FrodoVDR/PylontechMonitoring_ESP32-S3/hardware/PylontechInterface.kicad_sch

## KiCad design hardware/PylontechInterface.kicad_sch (2026-07-24)

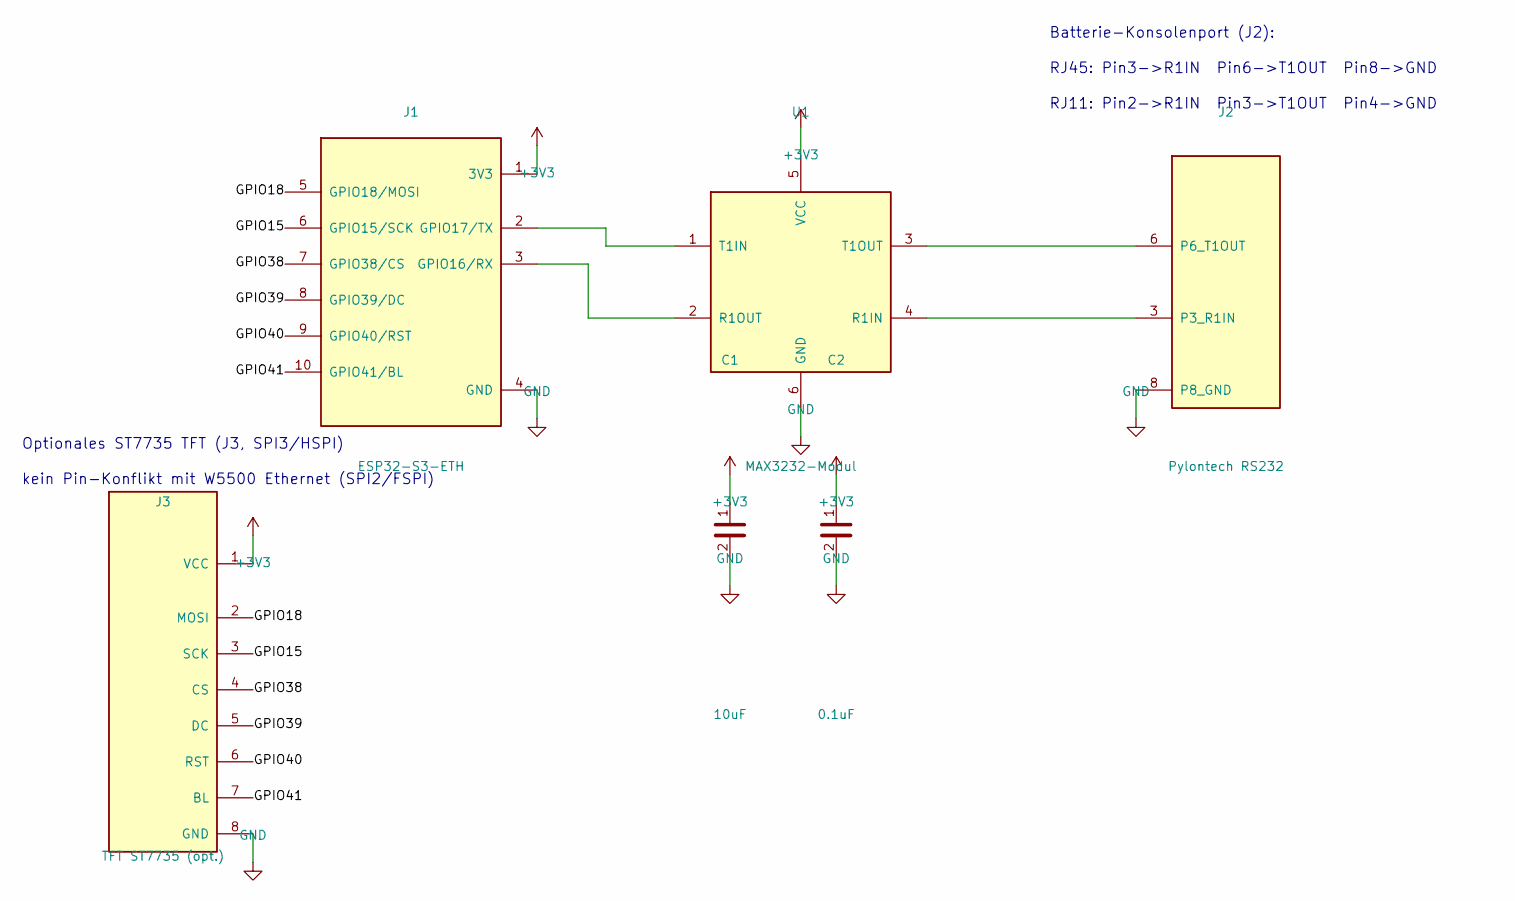
[picture p2: schematic PylontechInterface.kicad_sch]

Parts:
C1: 10uF
C2: 0.1uF
J1: ESP32-S3-ETH
J2: Pylontech RS232
J3: TFT ST7735 (opt.)
U1: MAX3232-Modul

Connections:
+3V3: C1.1, C2.1, J1.1 (3V3), J3.1 (VCC), U1.5 (VCC)
GND: C1.2, C2.2, J1.4 (GND), J2.8 (P8_GND), J3.8 (GND), U1.6 (GND)
GPIO15: J1.6 (GPIO15/SCK), J3.3 (SCK)
GPIO18: J1.5 (GPIO18/MOSI), J3.2 (MOSI)
GPIO38: J1.7 (GPIO38/CS), J3.4 (CS)
GPIO39: J1.8 (GPIO39/DC), J3.5 (DC)
GPIO40: J1.9 (GPIO40/RST), J3.6 (RST)
GPIO41: J1.10 (GPIO41/BL), J3.7 (BL)
unnamed: J1.2 (GPIO17/TX), U1.1 (T1IN)
unnamed: J1.3 (GPIO16/RX), U1.2 (R1OUT)
unnamed: J2.3 (P3_R1IN), U1.4 (R1IN)
unnamed: J2.6 (P6_T1OUT), U1.3 (T1OUT)

Notes on the sheet:
Batterie-Konsolenport (J2):
RJ45: Pin3->R1IN Pin6->T1OUT Pin8->GND
RJ11: Pin2->R1IN Pin3->T1OUT Pin4->GND
Optionales ST7735 TFT (J3, SPI3/HSPI)
kein Pin-Konflikt mit W5500 Ethernet (SPI2/FSPI)
