FrodoVDR/PylontechMonitoring_ESP32-S3/config.h

#pragma once
#include <Arduino.h>
#include <Preferences.h>
#include <map>
#include <vector>
#include <utility>
#include <freertos/FreeRTOS.h>
#include <freertos/semphr.h>

// Mutexes für thread-sicheren Zugriff auf lastParsedStat / lastParsedInfo / lastParsedBat / PWR-Buffer
extern SemaphoreHandle_t g_statMutex;
extern SemaphoreHandle_t g_infoMutex;
extern SemaphoreHandle_t g_batMutex;

// Boot-time reset/crash snapshot (defined in PylontechMonitoring.ino),
// exposed via /api/monitoring so the last crash stage survives log rotation.
extern String g_resetReasonStr;
extern uint32_t g_bootCrashStage;
extern const char* g_bootCrashStageName;
extern uint32_t g_bootCrashCount;
extern uint32_t g_bootCrashStageNRT;
extern const char* g_bootCrashStageNRTName;
extern SemaphoreHandle_t g_pwrMutex;
extern SemaphoreHandle_t g_healthMutex;

// ---------------------------------------------------------
// Timezone entry structure (Region → City → IANA → POSIX)
// ---------------------------------------------------------
struct TimezoneEntry {
    const char* region;
    const char* city;
    const char* tzName;
    const char* posix;
};


String getTimezoneJson();
String findPosixForTimezone(const String& tzName);
extern const TimezoneEntry TIMEZONES[];
extern const size_t TIMEZONE_COUNT;
// Magic-Header-Deklaration
extern const char OTA_MAGIC_HEADER[];
// ---------------------------------------------------------
// FieldConfig
// ---------------------------------------------------------

struct FieldConfig {
    String label;      // UI label
    String display;    // NEW: MQTT display name (CamelCase)
    String factor;
    String unit;
    bool mqtt;
    bool send;
};

// ---------------------------------------------------------
// Battery configuration
// ---------------------------------------------------------
struct BatteryConfig {
    unsigned long intervalPwr  = 60000;
    unsigned long intervalBat  = 300000;
    unsigned long intervalStat = 1800000;
    unsigned long intervalInfo = 3600000;

    bool enableBat  = false;
    bool enableStat = false;
    bool enableInfo = false;

    bool useFahrenheit = false;

    uint8_t maxModules = 16;

    std::map<String, FieldConfig> fieldsPwr;
    std::map<String, FieldConfig> fieldsBat;
    std::map<String, FieldConfig> fieldsStat;
    std::map<String, FieldConfig> fieldsInfo;

    float cellDiffWarn = 0.038f;   // 38 mV Warnschwelle
    float cellDiffError = 0.040f;  // 40 mV Fehlerschwelle

};

// ---------------------------------------------------------
// MQTT configuration
// ---------------------------------------------------------
struct MqttConfig {
    bool enabled = false;

    String server = "";
    uint16_t port = 1883;
    String user = "";
    String pass = "";

    String prefix     = "Pylontech";
    String topicStack = "Stack";
    String topicPwr   = "pwr";
    String topicBat   = "bat";
    String topicStat  = "stat";
    String topicInfo  = "info";
    String cellPrefix = "Cell";   // NEW: configurable cell prefix

    String mode = "active";
};

// ---------------------------------------------------------
// Battery data structures (PWR / BAT / STAT)
// ---------------------------------------------------------

// Fragmentation-resistant drop-in replacement for std::map<String,String>
// used by BatteryModule.fields. A std::map allocates one scattered heap node
// per entry (heavy DRAM fragmentation) and re-allocates the whole tree on every
// deep copy of PwrBuffer. This keeps the call-site API used in the codebase
// (operator[], find/end, range-for with kv.first/kv.second) but stores all
// entries in a single contiguous, reservable vector buffer.
class FieldMap {
public:
    using storage = std::vector<std::pair<String, String>>;
    using iterator = storage::iterator;
    using const_iterator = storage::const_iterator;

    // Insert-or-return-reference, mirroring std::map::operator[].
    String& operator[](const String& key) {
        for (auto& kv : items_) {
            if (kv.first == key) return kv.second;
        }
        items_.emplace_back(key, String());
        return items_.back().second;
    }

    const_iterator find(const String& key) const {
        for (const_iterator it = items_.begin(); it != items_.end(); ++it) {
            if (it->first == key) return it;
        }
        return items_.end();
    }
    iterator find(const String& key) {
        for (iterator it = items_.begin(); it != items_.end(); ++it) {
            if (it->first == key) return it;
        }
        return items_.end();
    }

    size_t count(const String& key) const { return find(key) != items_.end() ? 1u : 0u; }

    iterator begin() { return items_.begin(); }
    iterator end() { return items_.end(); }
    const_iterator begin() const { return items_.begin(); }
    const_iterator end() const { return items_.end(); }

    bool empty() const { return items_.empty(); }
    size_t size() const { return items_.size(); }
    void clear() { items_.clear(); }
    void reserve(size_t n) { items_.reserve(n); }

private:
    storage items_;
};

struct BatteryModule {
    bool present = false;
    int hub   = 0;   // 0 = no hub / stack mode
    int stack = 0;   // 1..5 in hub mode
    int index = 0;   // module index (Power/Module)
    int voltage_mV = 0;
    int current_mA = 0;
    int temperature = 0;
    int soc = 0;
    FieldMap fields;
};

struct BatteryStack {
    int batteryCount = 0;
    int avgVoltage_mV = 0;
    int totalCurrent_mA = 0;
    int temperature = 0;
    int soc = 0;

    int stackID = 0;   // <--- ADD THIS
    int hubID = 0;     // <--- OPTIONAL, useful for Masterhub

    void reset() {
        batteryCount = 0;
        avgVoltage_mV = 0;
        totalCurrent_mA = 0;
        temperature = 0;
        soc = 0;
    }
};

struct BatField {
    String name;
    String raw;
    // int moduleIndex;  // optional
};

struct BatData {
    int moduleIndex;               // NEW: module number (1..N)
    int cellIndex = -1;
    std::vector<BatField> fields;
};

struct StatField {
    String name;
    String raw;
};

struct StatData {
    int moduleIndex = -1;
    std::vector<StatField> fields;
};

struct InfoField {
    String name;
    String raw;
};

struct InfoData {
    int moduleIndex = -1;
    std::vector<InfoField> fields;
};

// ---------------------------------------------------------
// ParsedData + Double Buffer
// ---------------------------------------------------------
struct ParsedData {
    BatteryStack stack;
    std::vector<BatteryModule> modules;
    std::vector<BatData> batCells;
    StatData stat;
};

//extern ParsedData bufferA;      //alt
//extern ParsedData bufferB;      //alt
//extern volatile bool useA;      //alt

struct PwrBuffer {
    BatteryStack stack;
    std::vector<BatteryModule> modules;
};

struct BatBuffer {
    std::vector<BatData> cells;
};

struct StatBuffer {
    StatData stat;
};

struct InfoBuffer {
    InfoData info;
};

// Per-module pending publish buffers (avoids race condition)
#define MAX_BATTERY_MODULES 17
extern InfoData  g_pendingInfo[MAX_BATTERY_MODULES];
extern volatile bool g_pendingInfoReady[MAX_BATTERY_MODULES];
extern StatData  g_pendingStat[MAX_BATTERY_MODULES];
extern volatile bool g_pendingStatReady[MAX_BATTERY_MODULES];

// Doppelbuffer für PWR
extern PwrBuffer pwrA;
extern PwrBuffer pwrB;
extern volatile bool pwrUseA;

// Doppelbuffer für BAT
extern BatBuffer batA;
extern BatBuffer batB;
extern volatile bool batUseA;

// Doppelbuffer für STAT
extern StatBuffer statA;
extern StatBuffer statB;
extern volatile bool statUseA;

// Doppelbuffer für INFO
extern InfoBuffer infoA;
extern InfoBuffer infoB;
extern volatile bool infoUseA;


enum ParseResult {
    PARSE_OK,
    PARSE_FAIL,
    PARSE_IGNORED
};

#define MAX_MODULES 80

enum FrameType {
    FRAME_PWR,
    FRAME_BAT,
    FRAME_STAT
};

struct ParsedFrame {
    FrameType type;
    uint8_t index;

    BatteryStack stack;
    BatteryModule modules[MAX_MODULES];
    BatData bat;
    StatData stat;
};
// ---------------------------------------------------------
// Battery operating mode (Stack / Hub / Unknown)
// ---------------------------------------------------------
enum class BatteryMode {
    UNKNOWN = 0,
    STACK   = 1,
    HUB     = 2
};

// Global mode variable
extern BatteryMode g_batteryMode;


// ---------------------------------------------------------
// Parser / MQTT Flags
// ---------------------------------------------------------
extern bool parserHasData;
extern bool newParserData;

extern bool batParserHasData;
extern int  batParserModuleIndex;

extern bool statParserHasData;
extern int  statParserModuleIndex;

extern bool infoParserHasData;
extern int  infoParserModuleIndex;

extern bool discoveryPwrNeeded;
extern bool discoveryBatNeeded;
extern bool discoveryStatNeeded;
extern bool discoveryInfoNeeded;

// ---------------------------------------------------------
// AppConfig
// ---------------------------------------------------------
class AppConfig {
public:
    String deviceName = "PylontechMonitor";
    String hostname   = "";
    String wifiSSID   = "";
    String wifiPass   = "";
    String apSSID     = "";
    String apPass     = "";
    bool setupDone    = false;

    // WiFi static IP
    bool useStaticIP  = false;
    String ipAddr     = "";
    String subnetMask = "";
    String gateway    = "";
    String dns        = "";

    // Ethernet (W5500 SPI – defaults match Waveshare ESP32-S3-ETH)
    bool    useEthernet     = false;
    int8_t  ethPhyAddr      = 1;
    int8_t  ethMisoPin      = 12;
    int8_t  ethMosiPin      = 11;
    int8_t  ethSclkPin      = 13;
    int8_t  ethCsPin        = 14;
    int8_t  ethRstPin       = 9;
    int8_t  ethIntPin       = 10;

    // Ethernet static IP (independent from WiFi)
    bool    ethUseStaticIP  = false;
    String  ethIpAddr       = "";
    String  ethSubnetMask   = "";
    String  ethGateway      = "";
    String  ethDns          = "";

    // Runtime flag shared between WiFiManager and EthManager
    // to prevent double-starting ArduinoOTA
    bool otaStarted = false;

    String ntpServer = "pool.ntp.org";
    bool manual_mode = false;
    bool manual_dst = false;
    bool use_gateway_ntp = false;
    bool manual_ntp = false;
    String manual_date = "";
    String manual_time = "";

    String timezone = "Europe/Berlin";
    bool daylightSaving = true;
    uint32_t ntpResyncInterval = 86400;

    MqttConfig mqtt;
    BatteryConfig battery;

    String firmwareVersion = "1.3.1";
    String currentTime     = "";
    String lastPwrUpdate   = "";
    uint16_t detectedModules = 0;

    String lastMqttContact = "";

    void load();
    void save();

    void loadSystemConfig();
    void saveSystemConfig();

    void loadPwrConfig();
    void savePwrConfig();
    void loadPwrFields();
    void savePwrFields();

    void loadBatConfig();
    void saveBatConfig();
    void loadBatFields();
    void saveBatFields();

    void loadStatConfig();
    void saveStatConfig();
    void loadStatFields();
    void saveStatFields();

    void loadInfoConfig();
    void saveInfoConfig();
    void loadInfoFields();
    void saveInfoFields();

    void clearNVS();
    void factoryDefaults();
    void factoryReset();

    String uptimeString();
    String getCurrentTimeString();
    bool isSystemTimeValid();

    String getBuildNumber() const;
    String getFirmwareVersionWithBuild() const;
    
    // Get timezone offset in hours (e.g. +1 for CET, +2 for CEST)
    int getTimezoneOffsetHours() const;

    bool logInfo  = true;
    bool logWarn  = true;
    bool logError = true;
    bool logDebug = false;

    bool syslogEnabled = false;
    String syslogServer = "";
    uint16_t syslogPort = 514;

private:
    String generateHostname();
    void saveJsonChunked(const char* ns, const char* prefix, const String& json);
    String loadJsonChunked(const char* ns, const char* prefix);
};
struct ModuleHealth {
    int index = 0;

    float tempMax = 0;      // höchste Temperatur (Tempr oder Thigh)
    float cellMin = 0;      // Vlow
    float cellMax = 0;      // Vhigh
    float cellDiff = 0;     // Delta

    String strongestState = "Normal";  // stärkster Status
    String status = "OK";              // OK / Warnung / Fehler
};

struct HealthStatus {
    std::vector<ModuleHealth> modules;

    std::vector<int> okModules;
    std::vector<int> warnModules;
    std::vector<int> errorModules;

    std::vector<int> warnHistory;
    std::vector<int> errorHistory;

    float stackCellMin = 0;
    float stackCellMax = 0;
    float stackCellDiff = 0;

    String strongestMessage = "OK";
    String color = "green"; // green, yellow, red
};

extern HealthStatus health;


extern AppConfig config;
