FrodoVDR/PylontechMonitoring_ESP32-S3/checkmk/agent_pylontech_ruleset.py

#!/usr/bin/env python3
"""
CheckMK WATO Ruleset Plugin for PylontechMonitoring Custom Agent (REFERENCE ONLY)

!!! DO NOT DEPLOY THIS FILE ON CheckMK 2.4 !!!

This legacy WATO ruleset is written against the CheckMK 2.1/2.2 GUI plugin API
(`cmk.gui.plugins.wato`, `cmk.gui.cee.plugins.wato.agent_bakery`). On 2.4 it is
both unnecessary and actively harmful:

  * `cmk.gui.plugins.wato.datasource_programs` is a plain MODULE (.py) on 2.4, not
    a package. Dropping this file into a `.../wato/datasource_programs/` DIRECTORY
    in the site's local overlay makes the plugin loader try to import
    `...datasource_programs.agent_pylontech`, which fails with
    "datasource_programs is not a package". That aborts `cmk-update-config` /
    `omd update` and puts the Docker container into a restart loop
    (observed on the p32 -> p33 update, 2026-07).
  * `BakeryHostSettings` lives in the enterprise (CEE) tree and cannot be imported
    on the RAW edition anyway.

Correct setup on 2.4 (see CHECKMK_DEPLOYMENT.md): NO custom WATO plugin is needed.
Deploy only the special agent script `pylontech_custom_agent.py` to
`.../local/share/check_mk/agents/special/agent_pylontech` and wire it up with the
built-in rule "Individual program call instead of agent access". The threshold
defaults below are kept purely as documentation of the agent CLI options
(--heap-free-warn/crit, --heap-largest-warn/crit).
"""

from cmk.gui.i18n import _
from cmk.gui.plugins.wato import (
    HostRulespec,
    rulespec_registry,
)
from cmk.gui.cee.plugins.wato.agent_bakery.type_defs import BakeryHostSettings
from cmk.gui.valuespec import (
    TextInput,
    Integer,
    DropdownChoice,
    Tuple,
    Dictionary,
    HostAddress,
)


def _valuespec_agent_pylontech() -> Dictionary:
    """Define WATO value specification for PylontechMonitoring agent."""
    return Dictionary(
        title=_("Pylontech Monitoring (ESP32-S3)"),
        help=_(
            "Monitor Pylontech battery systems via ESP32-S3 running PylontechMonitoring firmware. "
            "The ESP32 device exposes a JSON API at /api/monitoring with system metrics "
            "(uptime, CPU load per core, heap/PSRAM, SPIFFS, NVS). "
            "This plugin fetches those metrics and converts them to CheckMK services."
        ),
        elements=[
            (
                "host",
                HostAddress(
                    title=_("ESP32 Hostname/IP"),
                    help=_(
                        "Hostname or IP address of the PylontechMonitoring ESP32-S3 device. "
                        "Example: 192.168.88.22 or esp32-pylontech.local"
                    ),
                    allow_empty=False,
                ),
            ),
            (
                "port",
                Integer(
                    title=_("HTTP Port"),
                    help=_("HTTP port on which the ESP32 web server listens (default: 80)"),
                    default_value=80,
                    min_value=1,
                    max_value=65535,
                ),
            ),
            (
                "timeout",
                Integer(
                    title=_("Request Timeout"),
                    help=_("API request timeout in seconds (default: 3)"),
                    default_value=3,
                    min_value=1,
                    max_value=30,
                ),
            ),
            (
                "heap_free_levels",
                Tuple(
                    title=_("Free heap lower levels (bytes)"),
                    help=_(
                        "WARN/CRIT when the absolute free internal heap (heap_free) drops "
                        "to or below these values. Maps to the agent options "
                        "--heap-free-warn / --heap-free-crit."
                    ),
                    elements=[
                        Integer(
                            title=_("Warning at or below"),
                            default_value=22528,
                            unit=_("bytes"),
                            min_value=0,
                        ),
                        Integer(
                            title=_("Critical at or below"),
                            default_value=16384,
                            unit=_("bytes"),
                            min_value=0,
                        ),
                    ],
                ),
            ),
            (
                "heap_largest_levels",
                Tuple(
                    title=_("Largest free block lower levels (bytes)"),
                    help=_(
                        "WARN/CRIT when the largest contiguous free heap block "
                        "(heap_largest_block) drops to or below these values. This is the "
                        "key fragmentation/stability indicator: once it is too small, large "
                        "allocations fail and the device reboots even though total free heap "
                        "still looks fine. Maps to the agent options "
                        "--heap-largest-warn / --heap-largest-crit."
                    ),
                    elements=[
                        Integer(
                            title=_("Warning at or below"),
                            default_value=8192,
                            unit=_("bytes"),
                            min_value=0,
                        ),
                        Integer(
                            title=_("Critical at or below"),
                            default_value=6144,
                            unit=_("bytes"),
                            min_value=0,
                        ),
                    ],
                ),
            ),
        ],
        optional_keys=["port", "timeout", "heap_free_levels", "heap_largest_levels"],
    )


rulespec_registry.register(
    HostRulespec(
        group="datasource_programs",
        name="agent_pylontech",
        title=_("Pylontech Monitoring (Custom Agent)"),
        help=_(
            "Retrieve system monitoring data from PylontechMonitoring ESP32-S3 devices "
            "via the /api/monitoring JSON endpoint. Services include: Uptime, CPU, Memory, PSRAM, SPIFFS, NVS."
        ),
        valuespec=_valuespec_agent_pylontech,
        match="all",
    )
)
