FrodoVDR/PylontechMonitoring_ESP32-S3/(commit log)

2026-06-24 release 1.2.2
    [partitions.csv, pylontech_ota_spiffs.csv, pylontech_ota_spiffs_16M.csv]
2026-06-24 Update ESP32-S3 description in README
2026-06-24 Update hardware description for ESP32-S3 components
2026-06-24 cleanup partitions
    [partitions.csv, pylontech_ota_spiffs_16M.csv]
2026-06-24 fix pwr, stack and dashboard SOC
    [py_parser_pwr.cpp]
2026-06-26 add flow.set
2026-06-27 fix health check and change default values
    [config.h, py_parser_pwr.cpp]
2026-06-28 fix save stat settings
    [config.cpp, config.h]
2026-06-28 Crash fix: sporadic PANIC in the web loop
    [wp_webserver.cpp]
2026-06-29 Home Assistant discovery fix
    [config.h, py_mqtt.cpp]
2026-06-30 New Schematic Diagram
2026-07-04 Web UI: made the whole web interface fully responsive/touch-friendly so it works on mobile devices the same as on desktop
